rmsvdp/MPF1B-COMMS/recursos/PROTOBOARD.jpg

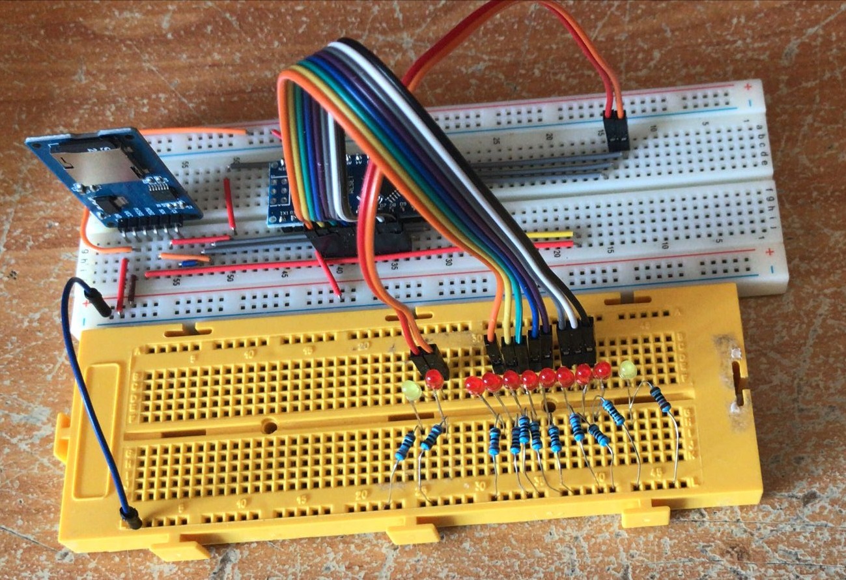
recursos/PROTOBOARD.jpg
