rmsvdp/MPF1B-COMMS/(commit log)

2025-07-02 wip 5 actualizado ino para probar test_04
2025-07-03 wip8 Arduino update
